Tony-b98/Tac-metro-Digital/Planos 3D/Imagenes/ChatGPT Image 16 sept 2026, 21_02_39.png

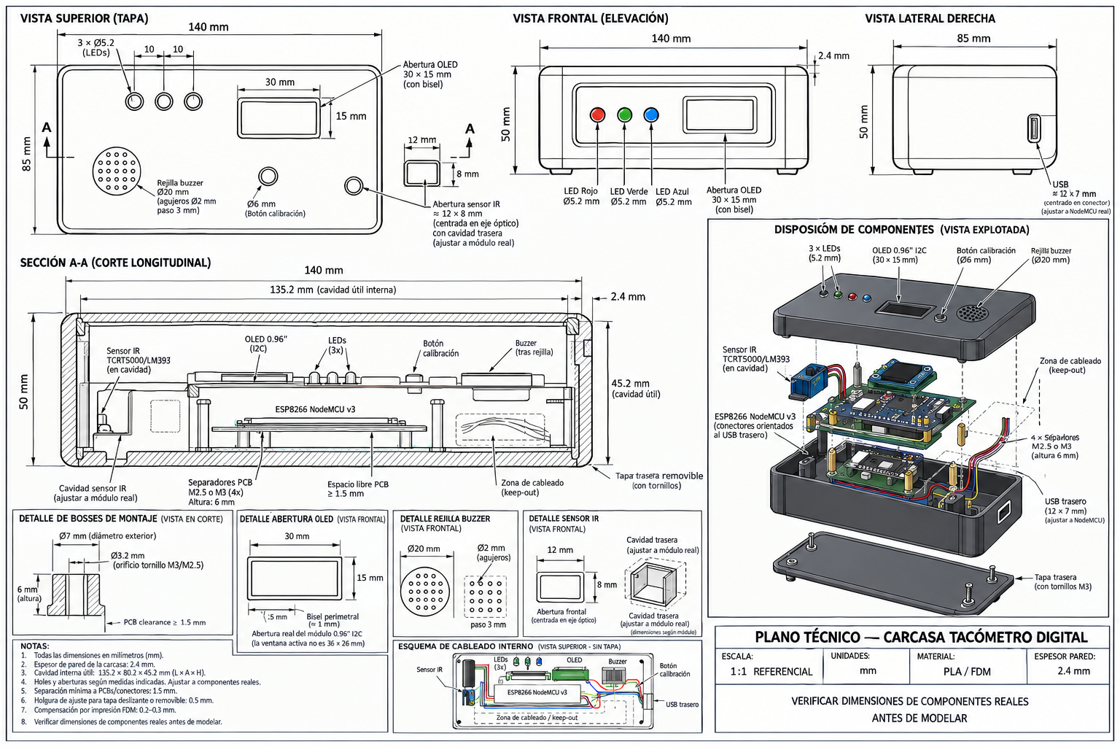
Planos 3D/Imagenes/ChatGPT Image 16 sept 2026, 21_02_39.png
