Tony-b98/Tac-metro-Digital/Planos 3D/Carcaza.png

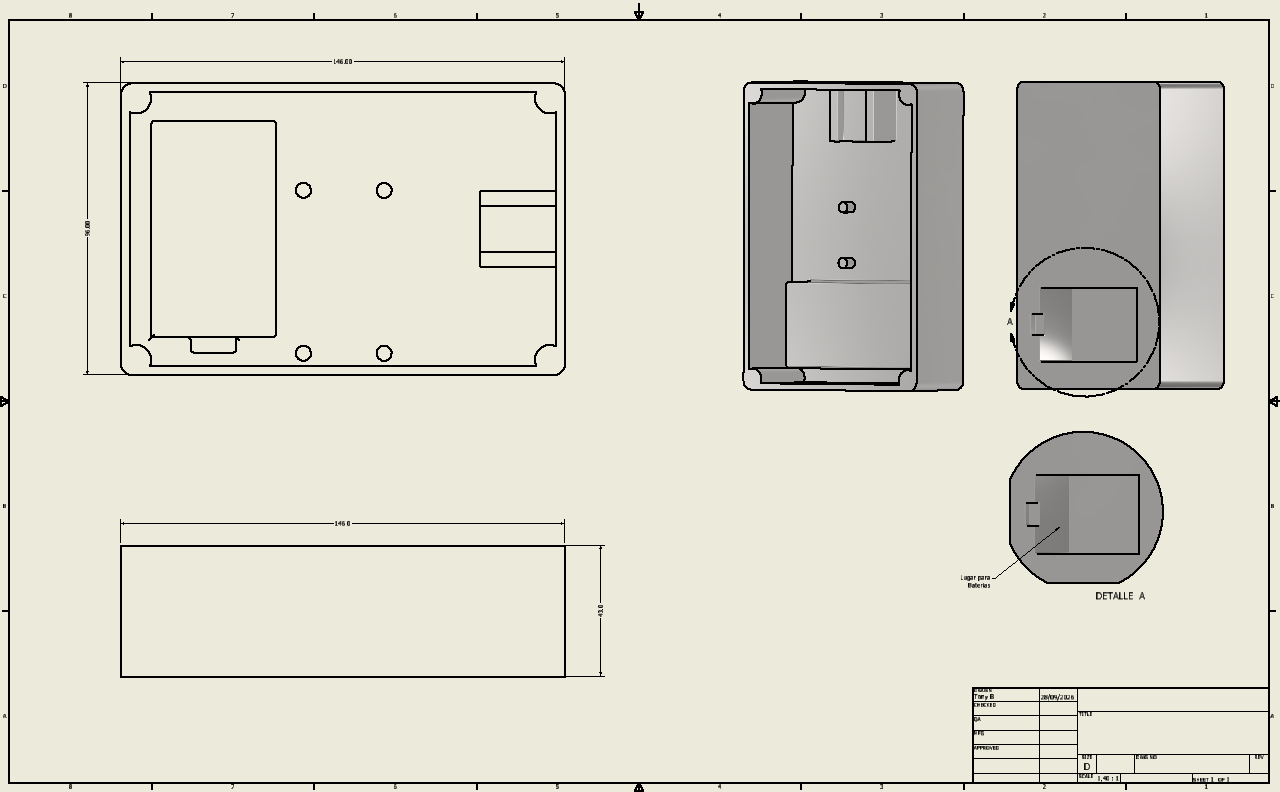
Planos 3D/Carcaza.png
