Tony-b98/Tac-metro-Digital/Planos 3D/Diseño_final.png

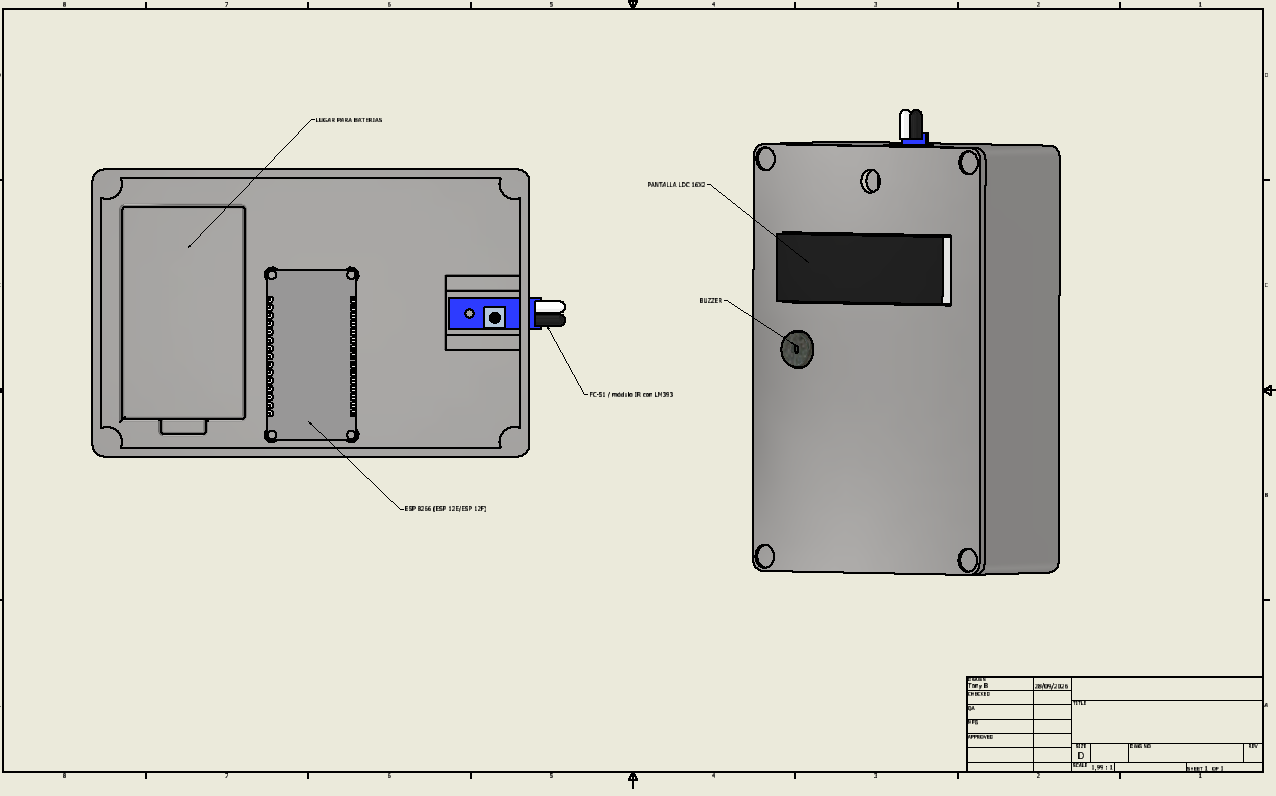
Planos 3D/Diseño_final.png
