Tony-b98/Tac-metro-Digital/Planos 3D/Imagenes/plano_tacometro_3d.png

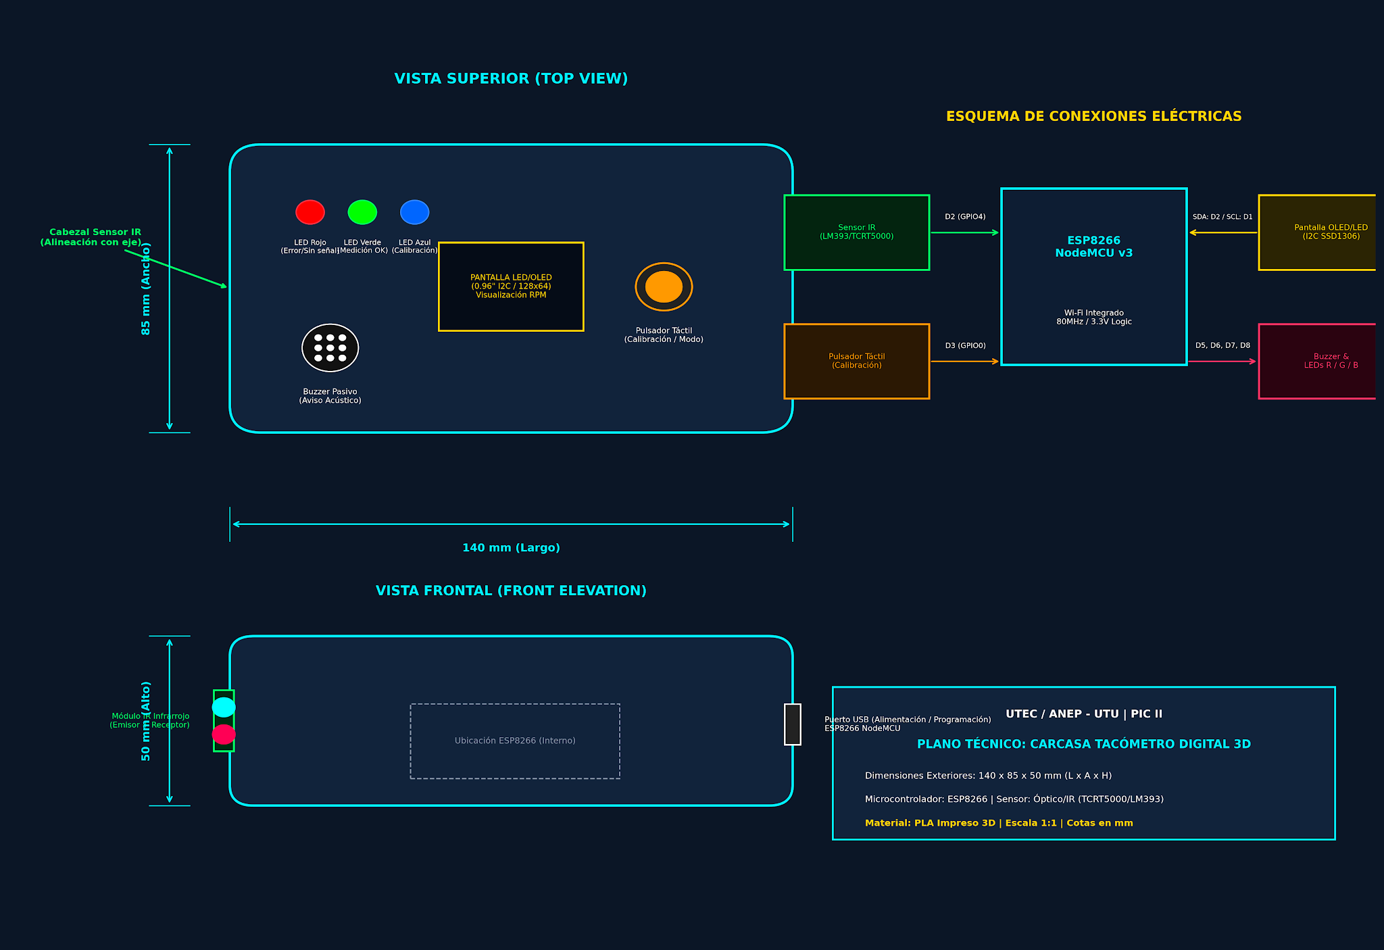
Planos 3D/Imagenes/plano_tacometro_3d.png
