Tony-b98/Tac-metro-Digital/Simulaciones/Esquema electrico.png

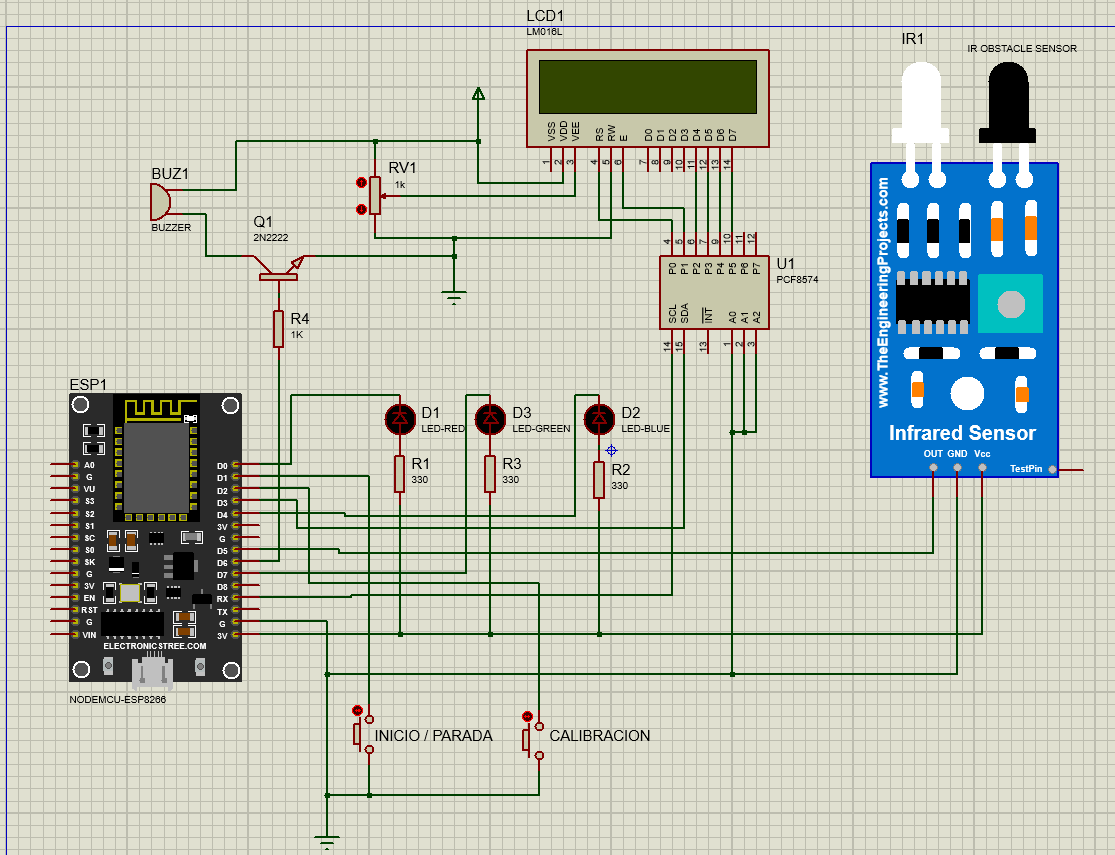
Simulaciones/Esquema electrico.png
