Tony-b98/Tac-metro-Digital/Documentacion/Datasheet/LISTA DE MATERIALES PIC2.xlsx

 |  | LISTA DE MATERIALES
Cant. | Material / componente | Modelo / característica | Función
1 | Microcontrolador | ESP 8266 (ESP-12E/ESP-12F) | Procesamiento y cálculo de RPM
1 | Sensor infrarrojo reflectivo | FC-51 / módulo IR con LM393 | Detectar cada vuelta del eje
1 | Pantalla LCD 16×2 | LCD1602 compatible HD44780 | Mostrar las RPM
1 | Módulo I²C para LCD | PCF8574 / PCF8574A | Comunicación I²C entre LCD y ESP8266
1 | Buzzer | Activo o pasivo (a confirmar) | Aviso sonoro
1 | Cinta reflectiva | Blanca / reflectante | Marca sobre el eje
1 | Protoboard | Estándar | Montaje del prototipo
Varios | Cables jumper | Según montaje | Conexiones
1 | Cable USB | Micro-USB, según NodeMCU | Programación y alimentación
1 | Fuente de alimentación | 5 V USB / según montaje final | Alimentación del sistema
1 | Motor / eje de prueba | Según banco de ensayo | Elemento para medir RPM
1 | Tacómetro de referencia | Comercial | Calibración y comparación
Según diseño | Resistencias | Valores a definir | Protección / polarización
Según diseño | Capacitores | Valores a definir | Filtrado / desacoplo
