Tony-b98/Tac-metro-Digital/(list of files, drawings)

Other design files:
Simulaciones/TacometroDigital.pdsprj
