Tony-b98/Tac-metro-Digital/(commit log)

2026-08-22 Creaciòn de repositorio
2026-10-22 Se agregar captura.h en el codigo y Carpeta documentacion
